dmpanch/rick_tv/rick-tv-pi/provisioning/videolooper/assets/README.md

# Videolooper framebuffer assets

Both `.fb` files are raw 640x480 BGRA framebuffer images for the project display:

- `transition-placeholder.fb` is used while switching channels.
- `interstitial-ad.fb` is used between videos inside the same Rick TV channel.

`interstitial-ad.fb` is derived from a cropped, text-free visible region of the public-domain cover of *Amazing Stories*, April 1942:

https://commons.wikimedia.org/wiki/File:Amazing_stories_194204.jpg

The crop is composed to keep the robot and alien attack scene fullscreen while excluding the original magazine masthead and story text.
