dmpanch/rick_tv/hardware/assets/dpdt-switch.jpg

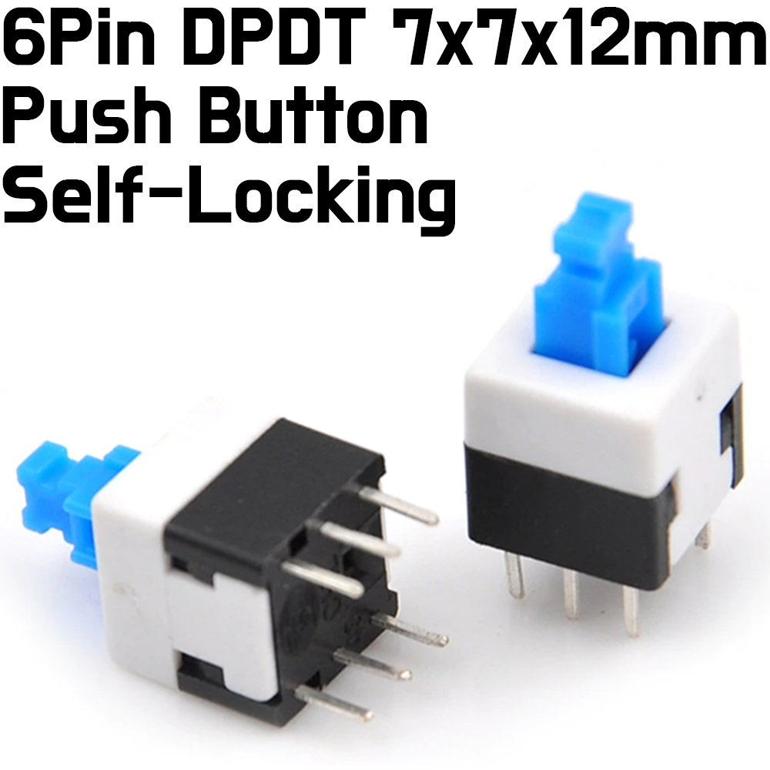
hardware/assets/dpdt-switch.jpg
