dmpanch/rick_tv/hardware/assets/pi-zero-w-back.jpg

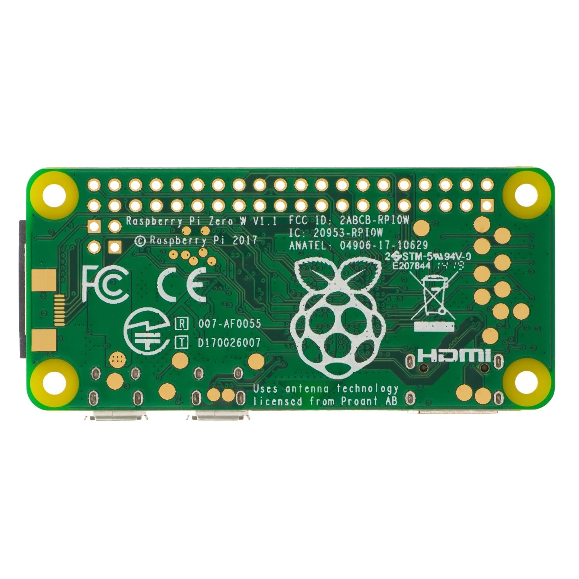
hardware/assets/pi-zero-w-back.jpg
