dmpanch/rick_tv/rick-tv-pi/provisioning/videolooper/overrides/video_looper.py

# Copyright 2015 Adafruit Industries.
# Author: Tony DiCola
# License: GNU GPLv2, see LICENSE.txt

import configparser
import importlib
import os
import re
import subprocess
import sys
import signal
import time
import urllib.parse
import select
import pygame
import json
import threading
from datetime import datetime
import RPi.GPIO as GPIO

from .alsa_config import parse_hw_device
from .model import Playlist, Movie

# Basic video looper architecure:
#
# - VideoLooper class contains all the main logic for running the looper program.
#
# - Almost all state is configured in a .ini config file which is required for
#   loading and using the VideoLooper class.
#
# - VideoLooper has loose coupling with file reader and video player classes that
#   are used to find movie files and play videos respectively.  The configuration
#   defines which file reader and video player module will be loaded.
#
# - A file reader module needs to define at top level create_file_reader function
#   that takes as a parameter a ConfigParser config object.  The function should
#   return an instance of a file reader class.  See usb_drive.py and directory.py
#   for the two provided file readers and their public interface.
#
# - Similarly a video player modules needs to define a top level create_player
#   function that takes in configuration.  See omxplayer.py and hello_video.py
#   for the two provided video players and their public interface.
#
# - Future file readers and video players can be provided and referenced in the
#   config to extend the video player use to read from different file sources
#   or use different video players.
class VideoLooper:

    def __init__(self, config_path):
        """Create an instance of the main video looper application class. Must
        pass path to a valid video looper ini configuration file.
        """
        # Load the configuration.
        self._config = configparser.ConfigParser(interpolation=None)
        if len(self._config.read(config_path)) == 0:
            raise RuntimeError(f"Failed to find configuration file at {config_path}, is the application properly installed?")
        self._console_output = self._config.getboolean('video_looper', 'console_output')
        # Load other configuration values.
        self._osd = self._config.getboolean('video_looper', 'osd')
        self._is_random_unique = self._config.getboolean('video_looper', 'is_random_unique', fallback=False)
        self._is_random = self._config.getboolean('video_looper', 'is_random', fallback=False) or self._is_random_unique
        self._one_shot_playback = self._config.getboolean('video_looper', 'one_shot_playback', fallback=False)
        self._play_on_startup = self._config.getboolean('video_looper', 'play_on_startup', fallback=True)
        self._resume_playlist = self._config.getboolean('video_looper', 'resume_playlist', fallback=False)
        self._playlist_path = self._config.get('playlist', 'path', fallback='')
        self._keyboard_control = self._config.getboolean('control', 'keyboard_control')
        self._keyboard_control_disabled_while_playback = self._config.getboolean('control', 'keyboard_control_disabled_while_playback')
        self._gpio_control_disabled_while_playback = self._config.getboolean('control', 'gpio_control_disabled_while_playback')
        self._copyloader = self._config.getboolean('copymode', 'copyloader')
        # Get seconds for countdown from config
        self._countdown_time = self._config.getint('video_looper', 'countdown_time')
        # Get seconds for waittime bewteen files from config
        self._wait_time = self._config.getint('video_looper', 'wait_time')
        # Get timedisplay settings
        self._datetime_display = self._config.getboolean('video_looper', 'datetime_display')
        self._top_datetime_display_format = self._config.get('video_looper', 'top_datetime_display_format', raw=True)
        self._bottom_datetime_display_format = self._config.get('video_looper', 'bottom_datetime_display_format', raw=True)
        # Parse string of 3 comma separated values like "255, 255, 255" into
        # list of ints for colors.
        self._bgcolor = list(map(int, self._config.get('video_looper', 'bgcolor')
                                             .translate(str.maketrans('','', ','))
                                             .split()))
        self._fgcolor = list(map(int, self._config.get('video_looper', 'fgcolor')
                                             .translate(str.maketrans('','', ','))
                                             .split()))
        # Initialize pygame display only when videolooper's own OSD is enabled.
        if self._osd:
            pygame.display.init()
            pygame.font.init()
            pygame.mouse.set_visible(False)
            self._screen = pygame.display.set_mode((0,0), pygame.FULLSCREEN | pygame.NOFRAME)
            self._size = (pygame.display.Info().current_w, pygame.display.Info().current_h)
            self._bgimage = self._load_bgimage() #a tupple with pyimage, xpos, ypos
            self._blank_screen()
        else:
            self._screen = None
            self._size = (0, 0)
            self._bgimage = (None, 0, 0)
        # Load configured video player and file reader modules.
        self._player = self._load_player()
        self._reader = self._load_file_reader()
        self._playlist = None
        # Load ALSA hardware configuration.
        self._alsa_hw_device = parse_hw_device(self._config.get('alsa', 'hw_device'))
        self._alsa_hw_vol_control = self._config.get('alsa', 'hw_vol_control')
        self._alsa_hw_vol_file = self._config.get('alsa', 'hw_vol_file')
        self._alsa_hw_vol = self._config.get('alsa', 'hw_vol', fallback=None)
        # Load sound volume file name value
        self._sound_vol_file = self._config.get('omxplayer', 'sound_vol_file')
        # default value to 0 millibels (omxplayer)
        self._sound_vol = 0
        # Set other static internal state.
        self._extensions = '|'.join(self._player.supported_extensions())
        if self._osd:
            self._small_font = pygame.font.Font(None, 50)
            self._medium_font   = pygame.font.Font(None, 96)
            self._big_font   = pygame.font.Font(None, 250)
        else:
            self._small_font = None
            self._medium_font = None
            self._big_font = None
        self._running    = True
        # set the inital playback state according to the startup setting.
        self._rick_tv_fifo_path = self._config.get(
            'rick_tv', 'command_fifo', fallback='/tmp/rick-tv-videolooper.fifo'
        )
        self._rick_tv_fifo = None
        self._rick_tv_open_fifo()
        self._rick_tv_playlist_reload = False
        self._rick_tv_pending_video_steps = []
        self._rick_tv_next_reader_check = 0.0
        self._rick_tv_current_playlist_path = None
        self._rick_tv_current_playlist_mtime = None
        self._rick_tv_transition_frame_path = '/home/pi/rick-tv/system/transition-placeholder.fb'
        self._rick_tv_transition_frame = None
        self._rick_tv_interstitial_frame_path = '/home/pi/rick-tv/system/interstitial-ad.fb'
        self._rick_tv_interstitial_frame = None
        self._rick_tv_skip_next_interstitial = False
        self._rick_tv_disable_framebuffer_placeholders = self._rick_tv_env_truthy('RICK_TV_DISABLE_FRAMEBUFFER_PLACEHOLDERS')
        self._rick_tv_clear_stale_framebuffer()
        self._playbackStopped = not self._play_on_startup
        #used for not waiting the first time
        self._firstStart = True

        # start keyboard handler thread:
        # Event handling for key press, if keyboard control is enabled
        if self._keyboard_control:
            self._keyboard_thread = threading.Thread(target=self._handle_keyboard_shortcuts, daemon=True)
            self._keyboard_thread.start()
        
        pinMapSetting = self._config.get('control', 'gpio_pin_map', raw=True)
        self._gpioPinMode = self._config.getboolean('control', 'gpio_pin_mode')

        if pinMapSetting:
            try:
                self._pinMap = json.loads("{"+pinMapSetting+"}")
                self._gpio_setup()
            except Exception:
                self._pinMap = None
                self._print("gpio_pin_map setting is not valid and/or error with GPIO setup")
        else:
            self._pinMap = None

    def _print(self, message):
        """Print message to standard output if console output is enabled."""
        if self._console_output:
            print(f"[{datetime.now()}] {message}")

    def _load_player(self):
        """Load the configured video player and return an instance of it."""
        module = self._config.get('video_looper', 'video_player')
        return importlib.import_module('.' + module, 'Adafruit_Video_Looper').create_player(self._config, screen=self._screen, bgimage=self._bgimage)

    def _load_file_reader(self):
        """Load the configured file reader and return an instance of it."""
        module = self._config.get('video_looper', 'file_reader')
        return importlib.import_module('.' + module, 'Adafruit_Video_Looper').create_file_reader(self._config, self._screen)

    def _load_bgimage(self):
        """Load the configured background image and return an instance of it."""
        image = None
        image_x = 0
        image_y = 0

        if self._config.has_option('video_looper', 'bgimage'):
            imagepath = self._config.get('video_looper', 'bgimage')
            if imagepath != "" and os.path.isfile(imagepath):
                self._print(f"Using {imagepath} as a background")
                image = pygame.image.load(imagepath)

                screen_w, screen_h = self._size
                image_w, image_h = image.get_size()

                screen_aspect_ratio = screen_w / screen_h
                photo_aspect_ratio = image_w / image_h

                if screen_aspect_ratio < photo_aspect_ratio:  # Width is binding
                    new_image_w = screen_w
                    new_image_h = int(new_image_w / photo_aspect_ratio)
                    image = pygame.transform.scale(image, (new_image_w, new_image_h))
                    image_y = (screen_h - new_image_h) // 2

                elif screen_aspect_ratio > photo_aspect_ratio:  # Height is binding
                    new_image_h = screen_h
                    new_image_w = int(new_image_h * photo_aspect_ratio)
                    image = pygame.transform.scale(image, (new_image_w, new_image_h))
                    image_x = (screen_w - new_image_w) // 2

                else:  # Images have the same aspect ratio
                    image = pygame.transform.scale(image, (screen_w, screen_h))

        return (image, image_x, image_y)

    def _is_number(self, s):
        try:
            float(s) 
            return True
        except ValueError:
            return False

    def _build_playlist(self) -> Playlist:
        """Try to build a playlist (object) from a playlist (file).
        Falls back to an auto-generated playlist with all files.
        """
        if self._playlist_path != "":
            if os.path.isabs(self._playlist_path):
                playlist_path = self._playlist_path
                if not os.path.isfile(self._playlist_path):
                    self._print(f"Playlist path {self._playlist_path} does not exist.")
                    return self._build_playlist_from_all_files()
                    #raise RuntimeError('Playlist path {0} does not exist.'.format(playlist_path))
            else:
                paths = self._reader.search_paths()
                
                if not paths:
                    return Playlist([], self._is_random, self._is_random_unique, self._resume_playlist)
                
                for path in paths:
                    maybe_playlist_path = os.path.join(path, self._playlist_path)
                    if os.path.isfile(maybe_playlist_path):
                        playlist_path = maybe_playlist_path
                        self._print(f"Playlist path resolved to {playlist_path}.")
                        break
                else:
                    self._print(f"Playlist path {self._playlist_path} does not resolve to any file.")
                    return self._build_playlist_from_all_files()
                    #raise RuntimeError('Playlist path {0} does not resolve to any file.'.format(playlist_path))

            basepath, extension = os.path.splitext(playlist_path)
            if extension == '.m3u' or extension == '.m3u8':
                return self._build_playlist_m3u(playlist_path)
            else:
                self._print(f'Unrecognized playlist format {extension}.')
                return self._build_playlist_from_all_files()
                #raise RuntimeError('Unrecognized playlist format {0}.'.format(extension))
        else:
            return self._build_playlist_from_all_files()
    
    def _build_playlist_m3u(self, playlist_path: str) -> Playlist:
        """
        Build a playlist from an M3U or M3U8 file.

        :param self: The instance of the video looper.
        :param playlist_path: The path to the M3U or M3U8 playlist file.
        :type playlist_path: str
        :return: A Playlist object containing the movies from the playlist file.
        :rtype: Playlist
        """
        playlist_dirname = os.path.dirname(playlist_path)
        movies = []

        title = None

        with open(playlist_path) as f:
            for line in f:
                if line.startswith('#'):
                    if line.startswith('#EXTINF'):
                        matches = re.match(r'^#\w+:\d+(?:\s*\w+\=\".*\")*,(.*)$', line)
                        if matches:
                            title = matches[1]
                else:
                    path = urllib.parse.unquote(line.rstrip())
                    if not os.path.isabs(path):
                        path = os.path.join(playlist_dirname, path)
                    movies.append(Movie(path, title))
                    title = None

        return Playlist(movies, self._is_random, self._is_random_unique, self._resume_playlist)

    def _build_playlist_from_all_files(self) -> Playlist:
        """Search all the file reader paths for movie files with the provided
        extensions.
        """
        # Get list of paths to search from the file reader.
        paths = self._reader.search_paths()
        # Enumerate all movie files inside those paths.
        movies = []
        for path in paths:
            # Skip paths that don't exist or are files.
            if not os.path.exists(path) or not os.path.isdir(path):
                continue

            for x in os.listdir(path):
                # Ignore hidden files (useful when file loaded on usb key from an OSX computer
                if x[0] != '.' and re.search(r'\.({0})$'.format(self._extensions), x, flags=re.IGNORECASE):
                    moviename = None
                    repeatsetting = re.search(r'_repeat_(-?)([0-9]*)x', x, flags=re.IGNORECASE)
                    if (repeatsetting is not None and repeatsetting.group(2) != ''):
                        repeat = int(repeatsetting.group(1) + repeatsetting.group(2))
                        moviename = os.path.splitext(re.sub(r'_repeat_(-?)([0-9]*)x', '', x, flags=re.IGNORECASE))[0]
                    else:
                        repeat = 1
                        moviename = os.path.splitext(x)[0]
                    movies.append(Movie(f"{path.rstrip('/')}/{x}", moviename, repeat))

            # Get the ALSA hardware volume from the file in the usb key
            if self._alsa_hw_vol_file:
                alsa_hw_vol_file_path = f"{path.rstrip('/')}/{self._alsa_hw_vol_file}"
                if os.path.exists(alsa_hw_vol_file_path):
                    with open(alsa_hw_vol_file_path, 'r') as alsa_hw_vol_file:
                        alsa_hw_vol_string = alsa_hw_vol_file.readline()
                        self._alsa_hw_vol = alsa_hw_vol_string
                    
            # Get the video volume from the file in the usb key
            if self._sound_vol_file:
                sound_vol_file_path = f"{path.rstrip('/')}/{self._sound_vol_file}"
                if os.path.exists(sound_vol_file_path):
                    with open(sound_vol_file_path, 'r') as sound_file:
                        sound_vol_string = sound_file.readline()
                        if self._is_number(sound_vol_string):
                            self._sound_vol = int(float(sound_vol_string))
        # Create a playlist with the sorted list of movies.
        return Playlist(sorted(movies), self._is_random, self._is_random_unique, self._resume_playlist)

    def _blank_screen(self):
        """Render a blank screen filled with the background color and optional the background image."""
        if not self._osd:
            return
        self._screen.fill(self._bgcolor)
        if self._bgimage[0] is not None:
            self._screen.blit(self._bgimage[0], (self._bgimage[1], self._bgimage[2]))
        pygame.display.flip()

    def _render_text(self, message, font=None):
        """Draw the provided message and return as pygame surface of it rendered
        with the configured foreground and background color.
        """
        # Default to small font if not provided.
        if font is None:
            font = self._small_font
        return font.render(message, True, self._fgcolor, self._bgcolor)

    def _animate_countdown(self, playlist):
        """Print text with the number of loaded movies and a quick countdown
        message if the on screen display is enabled.
        """
        # Print message to console with number of media files in playlist.
        message = f"Found {playlist.length()} media file{'s' if playlist.length() >= 2 else ''}."
        self._print(message)
        # Do nothing else if the OSD is turned off.
        if not self._osd:
            return
        # Draw message with number of movies loaded and animate countdown.
        # First render text that doesn't change and get static dimensions.
        label1 = self._render_text(message + " Starting playback in:")
        l1w, l1h = label1.get_size()
        sw, sh = self._screen.get_size()
        for i in range(self._countdown_time, 0, -1):
            # Each iteration of the countdown rendering changing text.
            label2 = self._render_text(str(i), self._big_font)
            l2w, l2h = label2.get_size()
            # Clear screen and draw text with line1 above line2 and all
            # centered horizontally and vertically.
            self._screen.fill(self._bgcolor)
            self._screen.blit(label1, (round(sw/2-l1w/2), round(sh/2-l2h/2-l1h)))
            self._screen.blit(label2, (round(sw/2-l2w/2), round(sh/2-l2h/2)))
            pygame.display.update()
            # Pause for a second between each frame.
            time.sleep(1)

    def _display_datetime(self):
        # returns suffix based on the day
        def get_day_suffix(day):
            if day in [1, 21, 31]:
                suffix = "st"
            elif day in [2, 22]:
                suffix = "nd"
            elif day in [3, 23]:
                suffix = "rd"
            else:
                suffix = "th"
            return suffix

        sw, sh = self._screen.get_size()

        for i in range(self._wait_time):
            if self._running:
                now = datetime.now()

                # Get the day suffix
                suffix = get_day_suffix(int(now.strftime('%d')))

                # Format the time and date strings
                top_format = self._top_datetime_display_format.replace('%d{SUFFIX}', f'%d{suffix}')
                bottom_format = self._bottom_datetime_display_format.replace('%d{SUFFIX}', f'%d{suffix}')

                top_str = now.strftime(top_format)
                bottom_str = now.strftime(bottom_format)

                # Render the time and date labels
                top_label = self._render_text(top_str, self._big_font)
                bottom_label = self._render_text(bottom_str, self._medium_font)

                # Calculate the label positions
                l1w, l1h = top_label.get_size()
                l2w, l2h = bottom_label.get_size()

                top_x = sw // 2 - l1w // 2
                top_y = sh // 2 - (l1h + l2h) // 2
                bottom_x = sw // 2 - l2w // 2
                bottom_y = top_y + l1h + 50

                # Draw the labels to the screen

                self._screen.fill(self._bgcolor)
                self._screen.blit(top_label, (top_x, top_y))
                self._screen.blit(bottom_label, (bottom_x, bottom_y))
                pygame.display.update()

                time.sleep(1)

    def _idle_message(self):
        """Print idle message from file reader."""
        # Print message to console.
        message = self._reader.idle_message()
        self._print(message)
        # Do nothing else if the OSD is turned off.
        if not self._osd:
            return
        # Display idle message in center of screen.
        label = self._render_text(message)
        lw, lh = label.get_size()
        sw, sh = self._screen.get_size()
        self._screen.fill(self._bgcolor)
        self._screen.blit(label, (sw/2-lw/2, sh/2-lh/2))
        # If keyboard control is enabled, display message about it
        if self._keyboard_control:
            label2 = self._render_text('press ESC to quit')
            l2w, l2h = label2.get_size()
            self._screen.blit(label2, (sw/2-l2w/2, sh/2-l2h/2+lh))
        pygame.display.update()

    def display_message(self,message):
        self._print(message)
        # Do nothing else if the OSD is turned off.
        if not self._osd:
            return
        # Display idle message in center of screen.
        label = self._render_text(message)
        lw, lh = label.get_size()
        sw, sh = self._screen.get_size()
        self._screen.fill(self._bgcolor)
        self._screen.blit(label, (sw/2-lw/2, sh/2-lh/2))
        pygame.display.update()

    def _prepare_to_run_playlist(self, playlist):
        """Display messages when a new playlist is loaded."""
        # If there are movies to play show a countdown first (if OSD enabled),
        # or if no movies are available show the idle message.
        self._blank_screen()
        self._firstStart = True
        self._print(f"Playlist:\n{playlist}")
        if playlist.length() > 0:
            self._animate_countdown(playlist)
            self._blank_screen()
        else:
            self._idle_message()

    def _set_hardware_volume(self):
        if self._alsa_hw_vol is not None:
            self._print(f"setting hardware volume (device: {self._alsa_hw_device}, control: {self._alsa_hw_vol_control}, value: {self._alsa_hw_vol})")
            cmd = ['amixer', '-M']
            if self._alsa_hw_device is not None:
                cmd.extend(('-c', str(self._alsa_hw_device[0])))
            cmd.extend(('set', self._alsa_hw_vol_control, '--', self._alsa_hw_vol))
            subprocess.check_call(cmd)
            
    def _rick_tv_open_fifo(self):
        if not self._rick_tv_fifo_path:
            return
        try:
            if not os.path.exists(self._rick_tv_fifo_path):
                os.mkfifo(self._rick_tv_fifo_path)
            os.chmod(self._rick_tv_fifo_path, 0o666)
            self._rick_tv_fifo = os.open(self._rick_tv_fifo_path, os.O_RDONLY | os.O_NONBLOCK)
            self._print(f"Rick TV command FIFO ready: {self._rick_tv_fifo_path}")
        except OSError as exc:
            self._rick_tv_fifo = None
            self._print(f"Rick TV command FIFO unavailable: {exc}")
    def _rick_tv_handle_fifo_commands(self):
        if self._rick_tv_fifo is None:
            return
        readable, _, _ = select.select([self._rick_tv_fifo], [], [], 0)
        if not readable:
            return
        try:
            payload = os.read(self._rick_tv_fifo, 4096).decode('utf-8')
        except OSError as exc:
            self._print(f"Rick TV command FIFO read failed: {exc}")
            return
        if payload == '':
            os.close(self._rick_tv_fifo)
            self._rick_tv_fifo = None
            self._rick_tv_open_fifo()
            return
        for command in payload.splitlines():
            command = command.strip()
            if not command:
                continue
            self._print(f"Rick TV FIFO command received: {command}")
            if command in ('next_video', 'previous_video'):
                self._rick_tv_pending_video_steps.append(1 if command == 'next_video' else -1)
                continue
            if '.m3u' in command:
                playlist_mtime = self._rick_tv_playlist_mtime(command)
                same_playlist = command == self._rick_tv_current_playlist_path
                self._print(
                    "Rick TV FIFO playlist command details: "
                    f"same_playlist={same_playlist}, "
                    f"playlist_mtime={playlist_mtime}, "
                    f"current_playlist={self._rick_tv_current_playlist_path}, "
                    f"current_mtime={self._rick_tv_current_playlist_mtime}"
                )
                if (
                    same_playlist
                    and playlist_mtime == self._rick_tv_current_playlist_mtime
                ):
                    self._print(f"Rick TV playlist command unchanged; ignoring: {command}")
                    continue
                if same_playlist:
                    self._print(
                        "Rick TV same-channel playlist refresh; transition placeholder suppressed: "
                        f"{command}"
                    )
                else:
                    self._print(f"Rick TV loading playlist: {command}")
                self._playlist_path = command
                self._print(f"Rick TV stopping player for playlist command: {command}")
                self._player.stop(0)
                if not same_playlist:
                    self._rick_tv_show_transition_placeholder()
                    self._print("Rick TV suppressing next interstitial after channel switch")
                    self._rick_tv_skip_next_interstitial = True
                self._playbackStopped = False
                self._rick_tv_pending_video_steps = []
                self._playlist = None
                self._rick_tv_playlist_reload = True
                self._rick_tv_current_playlist_path = command
                self._rick_tv_current_playlist_mtime = playlist_mtime

    def _rick_tv_apply_video_commands(self, movie):
        steps = self._rick_tv_pending_video_steps
        self._rick_tv_pending_video_steps = []
        if not steps or self._playlist is None or self._playlist.length() == 0:
            return movie
        for step in steps:
            self._playlist.seek(step)
            movie = self._playlist.get_next()
            movie.clear_playcount()
        self._player.stop(0)
        self._playbackStopped = False
        self._rick_tv_skip_next_interstitial = True
        self._print(f"Rick TV manual video selection: {movie}")
        return movie

    def _rick_tv_playlist_mtime(self, playlist_path):
        try:
            return os.path.getmtime(playlist_path)
        except OSError:
            return None

    def _rick_tv_reader_changed(self):
        now = time.monotonic()
        if now < self._rick_tv_next_reader_check:
            return False
        self._rick_tv_next_reader_check = now + 1.0
        return self._reader.is_changed()

    def _rick_tv_framebuffer_bytes(self):
        try:
            width, height = self._rick_tv_framebuffer_size()
            stride = self._rick_tv_read_int('/sys/class/graphics/fb0/stride')
        except OSError as exc:
            self._print(f"Rick TV transition placeholder framebuffer size unavailable: {exc}")
            return None
        return stride * height

    def _rick_tv_frame_for_display(self, frame_path):
        expected_bytes = self._rick_tv_framebuffer_bytes()
        if expected_bytes is None:
            return None

        try:
            fd = os.open(frame_path, os.O_RDONLY)
            try:
                frame = os.read(fd, 8 * 1024 * 1024)
            finally:
                os.close(fd)
        except OSError as exc:
            self._print(f"Rick TV transition/interstitial frame unavailable: {exc}")
            return None

        if len(frame) == expected_bytes:
            return frame
        if len(frame) > expected_bytes:
            self._print(
                f"Rick TV frame too large: got {len(frame)} bytes, expected {expected_bytes} bytes. Truncating."
            )
            return frame[:expected_bytes]
        self._print(
            f"Rick TV frame too small: got {len(frame)} bytes, expected {expected_bytes} bytes. Zero-padding."
        )
        return frame + b"\0" * (expected_bytes - len(frame))

    def _rick_tv_show_transition_placeholder(self):
        if not self._rick_tv_framebuffer_placeholders_enabled():
            self._print(
                "Rick TV transition placeholder disabled by RICK_TV_DISABLE_FRAMEBUFFER_PLACEHOLDERS"
            )
            return
        frame = self._rick_tv_transition_frame
        expected_bytes = self._rick_tv_framebuffer_bytes()
        if expected_bytes is None:
            return
        if frame is None:
            frame = self._rick_tv_frame_for_display(self._rick_tv_transition_frame_path)
            if frame is None:
                return
            if len(frame) != expected_bytes:
                return
            self._rick_tv_transition_frame = frame
        elif len(frame) != expected_bytes:
            frame = self._rick_tv_frame_for_display(self._rick_tv_transition_frame_path)
            if frame is None or len(frame) != expected_bytes:
                return
            self._rick_tv_transition_frame = frame
        if not frame:
            return
        self._rick_tv_prepare_framebuffer_console()
        try:
            fd = os.open('/dev/fb0', os.O_WRONLY)
            try:
                self._print("Rick TV showing transition placeholder")
                os.write(fd, frame)
            finally:
                os.close(fd)
        except OSError as exc:
            self._print(f"Rick TV transition placeholder unavailable: {exc}")

    def _rick_tv_show_interstitial_ad(self):
        if not self._rick_tv_framebuffer_placeholders_enabled():
            self._print(
                "Rick TV interstitial ad disabled by RICK_TV_DISABLE_FRAMEBUFFER_PLACEHOLDERS"
            )
            return
        frame = self._rick_tv_interstitial_frame
        expected_bytes = self._rick_tv_framebuffer_bytes()
        if expected_bytes is None:
            return
        if frame is None:
            frame = self._rick_tv_frame_for_display(self._rick_tv_interstitial_frame_path)
            if frame is None:
                return
            if len(frame) != expected_bytes:
                return
            self._rick_tv_interstitial_frame = frame
        elif len(frame) != expected_bytes:
            frame = self._rick_tv_frame_for_display(self._rick_tv_interstitial_frame_path)
            if frame is None or len(frame) != expected_bytes:
                return
            self._rick_tv_interstitial_frame = frame
        if not frame:
            return
        self._rick_tv_prepare_framebuffer_console()
        try:
            fd = os.open('/dev/fb0', os.O_WRONLY)
            try:
                self._print("Rick TV showing interstitial ad")
                os.write(fd, frame)
            finally:
                os.close(fd)
        except OSError as exc:
            self._print(f"Rick TV interstitial ad unavailable: {exc}")

    def _rick_tv_framebuffer_placeholders_enabled(self):
        return not self._rick_tv_disable_framebuffer_placeholders

    def _rick_tv_clear_stale_framebuffer(self):
        if not self._rick_tv_disable_framebuffer_placeholders:
            return
        expected_bytes = self._rick_tv_framebuffer_bytes()
        if expected_bytes is None:
            return
        try:
            fd = os.open('/dev/fb0', os.O_WRONLY)
            try:
                chunk = b'\0' * 65536
                remaining = expected_bytes
                while remaining > 0:
                    written = os.write(fd, chunk[:min(len(chunk), remaining)])
                    if written <= 0:
                        break
                    remaining -= written
                self._print(
                    "Rick TV cleared stale framebuffer because RICK_TV_DISABLE_FRAMEBUFFER_PLACEHOLDERS is enabled"
                )
            finally:
                os.close(fd)
        except OSError as exc:
            self._print(f"Rick TV stale framebuffer clear failed: {exc}")

    def _rick_tv_env_truthy(self, name):
        return self._rick_tv_env_value(name).strip().lower() in ('1', 'true', 'yes', 'on')

    def _rick_tv_env_value(self, name):
        value = os.environ.get(name)
        if value is not None:
            return value
        try:
            fd = os.open('/etc/rick-tv-pi.env', os.O_RDONLY)
            try:
                content = os.read(fd, 65536).decode('utf-8')
            finally:
                os.close(fd)
        except OSError:
            return ''

        for line in content.splitlines():
            line = line.strip()
            if not line or line.startswith('#') or '=' not in line:
                continue
            key, file_value = line.split('=', 1)
            if key.strip() != name:
                continue
            file_value = file_value.strip()
            if (
                len(file_value) >= 2
                and file_value[0] == file_value[-1]
                and file_value[0] in ('"', "'")
            ):
                file_value = file_value[1:-1]
            return file_value
        return ''

    def _rick_tv_prepare_framebuffer_console(self):
        try:
            fd = os.open('/sys/class/graphics/fbcon/cursor_blink', os.O_WRONLY)
            try:
                os.write(fd, b'0')
            finally:
                os.close(fd)
        except OSError:
            pass
        try:
            fd = os.open('/dev/tty1', os.O_WRONLY | os.O_NONBLOCK)
            try:
                os.write(fd, b'\033[?25l\033[2J\033[H')
            finally:
                os.close(fd)
        except OSError:
            pass

    def _rick_tv_build_transition_frame(self):
        try:
            width, height = self._rick_tv_framebuffer_size()
            bpp = self._rick_tv_read_int('/sys/class/graphics/fb0/bits_per_pixel')
            stride = self._rick_tv_read_int('/sys/class/graphics/fb0/stride')
        except OSError as exc:
            self._print(f"Rick TV transition placeholder init failed: {exc}")
            return None
        if bpp != 32:
            self._print(f"Rick TV transition placeholder unsupported bpp: {bpp}")
            return None

        frame = bytearray(stride * height)
        colors = (
            (190, 190, 190),
            (190, 190, 0),
            (0, 190, 190),
            (0, 190, 0),
            (190, 0, 190),
            (190, 0, 0),
            (0, 0, 190),
        )
        bar_width = max(1, width // len(colors))
        for y in range(height):
            for x in range(width):
                self._rick_tv_set_pixel(frame, stride, x, y, colors[min(x // bar_width, len(colors) - 1)])

        for i in range((width * height) // 24):
            x = (i * 1103515245 + 12345) % width
            y = (i * 214013 + 2531011) % height
            shade = (i * 37) % 256
            self._rick_tv_set_pixel(frame, stride, x, y, (shade, shade, shade))

        band_h = max(120, height // 5)
        band_y = height - band_h
        self._rick_tv_rect(frame, stride, 0, band_y, width, band_h, (0, 0, 0))
        self._rick_tv_rect_outline(frame, stride, width // 12, band_y + 24, width * 5 // 6, band_h - 48)
        self._rick_tv_draw_text(frame, stride, width // 2 - 110, band_y + 48, 'RICK TV', 7)
        self._rick_tv_draw_text(frame, stride, width // 2 - 144, band_y + 112, 'CHANNEL SYNC', 4)
        return bytes(frame)

    def _rick_tv_framebuffer_size(self):
        raw = self._rick_tv_read_text('/sys/class/graphics/fb0/virtual_size')
        width, height = raw.split(',', 1)
        return int(width), int(height)

    def _rick_tv_read_int(self, path):
        return int(self._rick_tv_read_text(path))

    def _rick_tv_read_text(self, path):
        fd = os.open(path, os.O_RDONLY)
        try:
            return os.read(fd, 128).decode('ascii').strip()
        finally:
            os.close(fd)

    def _rick_tv_set_pixel(self, frame, stride, x, y, rgb):
        r, g, b = rgb
        offset = y * stride + x * 4
        frame[offset:offset + 4] = bytes((b, g, r, 0))

    def _rick_tv_rect(self, frame, stride, x, y, w, h, rgb):
        for yy in range(max(0, y), max(0, y) + max(0, h)):
            for xx in range(max(0, x), max(0, x) + max(0, w)):
                self._rick_tv_set_pixel(frame, stride, xx, yy, rgb)

    def _rick_tv_rect_outline(self, frame, stride, x, y, w, h):
        for i in range(4):
            self._rick_tv_rect(frame, stride, x + i, y + i, w - i * 2, 1, (255, 255, 255))
            self._rick_tv_rect(frame, stride, x + i, y + h - i - 1, w - i * 2, 1, (255, 255, 255))
            self._rick_tv_rect(frame, stride, x + i, y + i, 1, h - i * 2, (255, 255, 255))
            self._rick_tv_rect(frame, stride, x + w - i - 1, y + i, 1, h - i * 2, (255, 255, 255))

    def _rick_tv_draw_text(self, frame, stride, x, y, text, scale):
        font = {
            'A': ('01110', '10001', '10001', '11111', '10001', '10001', '10001'),
            'C': ('01111', '10000', '10000', '10000', '10000', '10000', '01111'),
            'E': ('11111', '10000', '10000', '11110', '10000', '10000', '11111'),
            'H': ('10001', '10001', '10001', '11111', '10001', '10001', '10001'),
            'I': ('11111', '00100', '00100', '00100', '00100', '00100', '11111'),
            'K': ('10001', '10010', '10100', '11000', '10100', '10010', '10001'),
            'L': ('10000', '10000', '10000', '10000', '10000', '10000', '11111'),
            'N': ('10001', '11001', '10101', '10011', '10001', '10001', '10001'),
            'R': ('11110', '10001', '10001', '11110', '10100', '10010', '10001'),
            'S': ('01111', '10000', '10000', '01110', '00001', '00001', '11110'),
            'T': ('11111', '00100', '00100', '00100', '00100', '00100', '00100'),
            'V': ('10001', '10001', '10001', '10001', '10001', '01010', '00100'),
            'Y': ('10001', '10001', '01010', '00100', '00100', '00100', '00100'),
            ' ': ('00000', '00000', '00000', '00000', '00000', '00000', '00000'),
        }
        cursor = x
        for char in text:
            glyph = font.get(char.upper(), font[' '])
            for row, bits in enumerate(glyph):
                for col, bit in enumerate(bits):
                    if bit == '1':
                        self._rick_tv_rect(frame, stride, cursor + col * scale, y + row * scale, scale, scale, (255, 255, 255))
            cursor += 6 * scale

    def _handle_keyboard_shortcuts(self):
        self._print("keyboard control thread started")
        while self._running:
            event = pygame.event.wait()

            if self._keyboard_control_disabled_while_playback and self._player.is_playing():
                self._print("keyboard control disabled while playback is running")
                continue
            
            if event.type == pygame.KEYDOWN:
                # If pressed key is ESC quit program
                if event.key == pygame.K_ESCAPE:
                    self._print("ESC was pressed. quitting...")
                    self.quit()
                if event.key == pygame.K_k:
                    self._print("k was pressed. skipping...")
                    self._playlist.seek(1) # type: ignore
                    self._player.stop(0)
                    self._playbackStopped = False
                if event.key == pygame.K_s:
                    if self._playbackStopped:
                        self._print("s was pressed. starting...")
                        self._playbackStopped = False
                    else:
                        self._print("s was pressed. stopping...")
                        self._playbackStopped = True
                        self._player.stop(0)
                # space is pause/resume the playing video
                if event.key == pygame.K_SPACE:
                    self._print("Pause/Resume pressed")
                    self._player.pause()
                if event.key == pygame.K_p:
                    self._print("p was pressed. shutting down...")
                    self.quit(True)
                if event.key == pygame.K_b:
                    self._print("b was pressed. jumping back...")
                    self._playlist.seek(-1) # type: ignore
                    self._player.stop(0)
                    self._playbackStopped = False
                if event.key == pygame.K_o:
                    self._print("o was pressed. next chapter...")
                    self._player.sendKey("o")
                if event.key == pygame.K_i:
                    self._print("i was pressed. previous chapter...")
                    self._player.sendKey("i")
    
    def _handle_gpio_control(self, pin):
        if self._pinMap is None:
            return
        
        if self._gpio_control_disabled_while_playback and self._player.is_playing():
            self._print("gpio control disabled while playback is running")
            return
        
        action = self._pinMap[str(pin)]

        self._print(f"pin {pin} triggered: {action}")
        
        if action in ['K_ESCAPE', 'K_k', 'K_s', 'K_SPACE', 'K_p', 'K_b', 'K_o', 'K_i']:
            pygame.event.post(pygame.event.Event(pygame.KEYDOWN, key=getattr(pygame, action, None)))
        elif ".m3u" in action:
            self._playlist_path = action
            self._playlist = self._build_playlist()
            self._player.stop(0)
            self._playbackStopped = False
        else:
            self._playlist.set_next(action) # type: ignore
            self._player.stop(0)
            self._playbackStopped = False
    
    def _gpio_setup(self):
        if self._pinMap is None:
            return
        GPIO.setmode(GPIO.BOARD)
        for pin in self._pinMap:
            GPIO.setup(int(pin), GPIO.IN, pull_up_down=GPIO.PUD_UP if self._gpioPinMode else GPIO.PUD_DOWN)
            GPIO.add_event_detect(int(pin), GPIO.FALLING if self._gpioPinMode else GPIO.RISING, callback=self._handle_gpio_control,  bouncetime=200) 
            self._print(f"pin {pin} action set to: {self._pinMap[pin]}")

        
    def run(self):
        """Main program loop.  Will never return!"""
        # Get playlist of movies to play from file reader.
        self._playlist = self._build_playlist()
        self._prepare_to_run_playlist(self._playlist)
        self._set_hardware_volume()
        movie = self._playlist.get_next()
        # Main loop to play videos in the playlist and listen for file changes.
        while self._running:
            self._rick_tv_handle_fifo_commands()
            if self._rick_tv_playlist_reload:
                self._print("Rick TV playlist reload requested; rebuilding playlist")
                self._playlist = self._build_playlist()
                movie = self._playlist.get_next()
                self._rick_tv_playlist_reload = False

            movie = self._rick_tv_apply_video_commands(movie)

            # Load and play a new movie if nothing is playing.
            if not self._player.is_playing() and not self._playbackStopped:
                if movie is None:
                    self._print("Current playlist is empty")
                    self._playlist = self._build_playlist()
                    movie = self._playlist.get_next()
                    if movie is None:
                        self._player.stop(0)
                        time.sleep(0.1)
                        continue

                if movie is not None: #just to avoid errors

                    if movie.playcount >= movie.repeats:
                        if not (self._is_random and self._is_random_unique):
                            movie.clear_playcount()
                        movie = self._playlist.get_next()
                    elif self._player.can_loop_count() and movie.playcount > 0:
                        if not (self._is_random and self._is_random_unique):
                            movie.clear_playcount()
                        movie = self._playlist.get_next()
                        
                    ## check if movie is actually a m3u file
                    if movie is not None and ".m3u" in movie.filename: # type: ignore
                        self._playlist_path = movie.target # type: ignore
                        self._playlist = self._build_playlist()
                        movie = self._playlist.get_next()
                    if movie is None:
                        continue

                    if not self._firstStart:
                        if self._rick_tv_skip_next_interstitial:
                            self._print("Rick TV skipping interstitial after channel switch")
                        else:
                            self._rick_tv_show_interstitial_ad()
                    self._rick_tv_skip_next_interstitial = False
                    movie.was_played() # type: ignore

                    if self._wait_time > 0 and not self._firstStart:
                        if(self._datetime_display):
                            self._display_datetime()
                        else:
                            self._print(f"Waiting for: {self._wait_time} seconds")
                            time.sleep(self._wait_time)
                    self._firstStart = False

                    #player loop setting:
                    player_loop = -1 if self._playlist.length()==1 or movie.repeats == -1 else None # type: ignore
                    
                    #generating infotext
                    if self._player.can_loop_count():
                        infotext = f"{movie.repeats} time{'s' if movie.repeats>1 else ''} (player counts loops)" # type: ignore
                    else:
                        infotext = f"{movie.playcount}/{movie.repeats}" # type: ignore
                    if player_loop==-1:
                        infotext = '(endless loop)'

                    #special one-shot playback condition
                    if self._one_shot_playback:
                        self._playbackStopped = True
                        player_loop = None
                                        
                    # Start playing the first available movie.
                    self._print(f"Playing movie: {movie} {infotext}")
                    self._print(f"Rick TV player.play starting: {movie}")
                    # todo: maybe clear screen to black so that background (image/color) is not visible for videos with a resolution that is < screen resolution
                    self._player.play(movie, loop=player_loop, vol = self._sound_vol)

            # Check for changes in the file search path (like USB drives added)
            # and rebuild the playlist.
            if not self._playbackStopped and self._rick_tv_reader_changed():
                self._print("reader changed, stopping player")
                self._player.stop(0)  # Up to 3 second delay waiting for old 
                                      # player to stop.
                self._print("player stopped")
                # Rebuild playlist and show countdown again (if OSD enabled).
                self._playlist = self._build_playlist()
                #refresh background image
                if self._copyloader:
                    self._bgimage = self._load_bgimage()
                self._prepare_to_run_playlist(self._playlist)
                self._set_hardware_volume()
                movie = self._playlist.get_next()

            # Give the CPU some time to do other tasks. low values increase "responsiveness to changes" and reduce the pause between files
            # but increase CPU usage
            # since keyboard commands are handled in a seperate thread this sleeptime mostly influences the pause between files
                        
            time.sleep(0.05)

        self._print("run ended")
        pygame.quit()

    def quit(self, shutdown=False):
        """Shut down the program"""
        self._print("quitting Video Looper")

        if shutdown:
            os.system("sudo shutdown now")

        self._playbackStopped = True
        self._running = False
        if self._osd and pygame.get_init():
            pygame.event.post(pygame.event.Event(pygame.QUIT))

        if self._player is not None:
            self._player.stop()

        if self._pinMap:
            GPIO.cleanup()


    def signal_quit(self, signal, frame):
        """Shut down the program, meant to by called by signal handler."""
        self._print("received signal to quit")
        self.quit()

# Main entry point.
if __name__ == '__main__':
    print('Starting Adafruit Video Looper.')
    # Default config path to /boot.
    config_path = '/boot/video_looper.ini'
    # Override config path if provided as parameter.
    if len(sys.argv) == 2:
        config_path = sys.argv[1]
    # Create video looper.
    videolooper = VideoLooper(config_path)
    # Configure signal handlers to quit on TERM or INT signal.
    signal.signal(signal.SIGTERM, videolooper.signal_quit)
    signal.signal(signal.SIGINT, videolooper.signal_quit)
    # Run the main loop.
    videolooper.run()
