dmpanch/rick_tv/rick-tv-pi/src/rick_tv_pi/videolooper.py

from __future__ import annotations

import errno
import logging
import os
import random
import time
from dataclasses import dataclass
from pathlib import Path
from typing import Callable, Iterable, Optional, Tuple

from rick_tv_pi.channels import Channel

logger = logging.getLogger(__name__)


@dataclass(frozen=True)
class PlayableFile:
    path: Path


class VideolooperController:
    def __init__(
        self,
        playlist_root: Path,
        command_path: Path = Path("/tmp/rick-tv-videolooper.fifo"),
        command_writer: Optional[Callable[[str], None]] = None,
        shuffle_interval_seconds: int = 3600,
        shuffler: Optional[Callable[[list[Path]], list[Path]]] = None,
    ) -> None:
        self.screen_state: str = "empty"
        self.current_file: Optional[PlayableFile] = None
        self._current_channel: Optional[Channel] = None
        self._current_commanded_channel_id: Optional[str] = None
        self._playlist_root = playlist_root
        self._channels_root = playlist_root / "channels"
        self._master_playlist_path = playlist_root / "channels.m3u"
        self._command_path = command_path
        self._command_writer = command_writer or self._write_fifo_command
        self._last_playlist_text_by_channel = {}
        self._last_file_set_by_channel = {}
        self._last_master_playlist_text: Optional[str] = None
        self._next_shuffle_at_by_channel = {}
        self._changed_channel_ids = set()
        self._shuffle_interval_seconds = shuffle_interval_seconds
        self._shuffler = shuffler or _shuffle_files
        self._file_cache = {}

    @property
    def master_playlist_path(self) -> Path:
        return self._master_playlist_path

    def sync_channels(self, channels: Iterable[Channel], now: Optional[float] = None) -> None:
        channels = list(channels)
        current_time = time.monotonic() if now is None else now
        self._playlist_root.mkdir(parents=True, exist_ok=True)
        self._channels_root.mkdir(parents=True, exist_ok=True)
        for channel in channels:
            self._write_channel_playlist_if_due(channel, current_time)

        master_playlist_text = self._build_master_playlist(channels)
        if master_playlist_text == self._last_master_playlist_text:
            return
        self._master_playlist_path.write_text(master_playlist_text)
        self._last_master_playlist_text = master_playlist_text

    def select_channel(self, channel: Channel) -> bool:
        if (
            self._current_channel is not None
            and self._current_channel.id == channel.id
            and self._current_commanded_channel_id == channel.id
        ):
            return True
        self._current_channel = channel
        self._write_channel_playlist_if_due(channel, time.monotonic())
        self._update_state(channel)
        if self.current_file is None:
            self._changed_channel_ids.discard(channel.id)
            return True
        command_sent = self._send_channel_command(channel, force=True)
        self._changed_channel_ids.discard(channel.id)
        return command_sent

    def rescan_current_channel(self, now: Optional[float] = None) -> None:
        if self._current_channel is None:
            self.screen_state = "empty"
            self.current_file = None
            return

        current_time = time.monotonic() if now is None else now
        self._write_channel_playlist_if_due(self._current_channel, current_time)
        self._update_state(self._current_channel)
        if (
            self.current_file is not None
            and self._current_channel.id in self._changed_channel_ids
        ):
            self._send_channel_command(self._current_channel, force=True)
            self._changed_channel_ids.discard(self._current_channel.id)

    def _write_channel_playlist_if_due(self, channel: Channel, now: float) -> bool:
        files = self._channel_files(channel)
        file_set = tuple(files)
        previous_file_set = self._last_file_set_by_channel.get(channel.id)
        next_shuffle_at = self._next_shuffle_at_by_channel.get(channel.id)
        due = (
            previous_file_set != file_set
            or next_shuffle_at is None
            or now >= next_shuffle_at
        )
        if not due:
            return False

        playlist_text, _first_file = self._build_channel_playlist(
            channel,
            files=files,
            shuffle=True,
        )
        last_playlist_text = self._last_playlist_text_by_channel.get(channel.id)
        if playlist_text != last_playlist_text:
            channel_playlist_path = self._channel_playlist_path(channel)
            channel_playlist_path.parent.mkdir(parents=True, exist_ok=True)
            channel_playlist_path.write_text(playlist_text)
            self._last_playlist_text_by_channel[channel.id] = playlist_text
            self._changed_channel_ids.add(channel.id)

        self._last_file_set_by_channel[channel.id] = file_set
        self._next_shuffle_at_by_channel[channel.id] = (
            now + self._shuffle_interval_seconds
        )
        return playlist_text != last_playlist_text

    def _update_state(self, channel: Channel) -> None:
        files = self._channel_files(channel)
        first_file = files[0] if files else None
        self.screen_state = "playing" if first_file is not None else "empty"
        self.current_file = PlayableFile(first_file) if first_file is not None else None

    def _build_master_playlist(self, channels: Iterable[Channel]) -> str:
        lines = ["#EXTM3U"]
        for channel in channels:
            if not self._channel_files(channel):
                continue
            lines.append(f"#EXTINF:0,{_channel_title(channel)}")
            lines.append(str(self._channel_playlist_path(channel)))
        return "\n".join(lines) + "\n"

    def _build_channel_playlist(
        self,
        channel: Channel,
        *,
        files: Optional[list[Path]] = None,
        shuffle: bool,
    ) -> Tuple[str, Optional[Path]]:
        files = self._channel_files(channel) if files is None else list(files)
        if not files:
            return "#EXTM3U\n", None
        if shuffle:
            files = self._shuffler(files)

        title = _channel_title(channel)
        lines = ["#EXTM3U"]
        for path in files:
            lines.append(f"#EXTINF:0,{title}")
            lines.append(str(path))
        return "\n".join(lines) + "\n", files[0]

    def _send_channel_command(self, channel: Channel, *, force: bool = False) -> bool:
        command = str(self._channel_playlist_path(channel))
        if not force and self._current_commanded_channel_id == channel.id:
            return True
        try:
            self._command_writer(command)
        except OSError as exc:
            logger.warning("Videolooper command pipe is unavailable: %s", exc)
            return False
        else:
            self._current_commanded_channel_id = channel.id
            return True

    def next_video(self) -> bool:
        return self._send_video_command("next_video")

    def previous_video(self) -> bool:
        return self._send_video_command("previous_video")

    def _send_video_command(self, command: str) -> bool:
        if self.current_file is None or self._current_channel is None:
            return False
        if not self._send_channel_command(self._current_channel):
            return False
        try:
            self._command_writer(command)
        except OSError as exc:
            logger.warning("Videolooper command pipe is unavailable: %s", exc)
            return False
        return True

    def _write_fifo_command(self, command: str) -> None:
        fd = os.open(str(self._command_path), os.O_WRONLY | os.O_NONBLOCK)
        try:
            os.write(fd, (command + "\n").encode("utf-8"))
        except OSError as exc:
            if exc.errno not in (errno.EPIPE, errno.ENXIO):
                raise
            logger.warning("Videolooper command pipe has no reader: %s", exc)
        finally:
            os.close(fd)

    def _channel_playlist_path(self, channel: Channel) -> Path:
        return self._channels_root / f"{channel.id}.m3u"

    def _channel_files(self, channel: Channel) -> list[Path]:
        try:
            stat = channel.path.stat()
            signature = (stat.st_dev, stat.st_ino, stat.st_mtime_ns, stat.st_ctime_ns)
            cached = self._file_cache.get(channel.path)
            if cached is None or cached[0] != signature:
                cached = (signature, _channel_files(channel))
                self._file_cache[channel.path] = cached
            return list(cached[1])
        except (FileNotFoundError, NotADirectoryError):
            self._file_cache.pop(channel.path, None)
            return []


def _channel_title(channel: Channel) -> str:
    if channel.display_name:
        return f"Channel {channel.number} - {channel.display_name}"
    return f"Channel {channel.number}"


def _channel_files(channel: Channel) -> list[Path]:
    return sorted(
        path
        for path in channel.path.iterdir()
        if path.is_file() and path.suffix.lower() == ".mp4"
    )


def _shuffle_files(files: list[Path]) -> list[Path]:
    files = list(files)
    random.shuffle(files)
    return files
