dmpanch/rick_tv/(commit log)

2026-05-18 feat: wire pi runtime entrypoint
2026-05-19 fix: wire archive delete confirmation
2026-05-19 Reduce touch-to-switch latency path for videolooper
2026-05-19 fix(pi): stabilize videolooper FIFO patching and channel switch path
2026-05-19 Fix videolooper swipe switching stalls on pi
2026-05-19 Reduce videolooper channel switch restarts
2026-05-19 Show framebuffer transition card during channel switches
2026-05-20 Fix videolooper interstitial/transition frame size normalization
2026-05-20 Fix interstitial frame resize when source framebuffer size mismatches
2026-05-20 Revert "Fix interstitial frame resize when source framebuffer size mismatches"
    This reverts commit 3d4362e3c9e2a081470c3721db18850db1a83b4c.
2026-05-20 Fix static framebuffer transition assets
2026-05-20 Prime interstitial framebuffer between videos
2026-05-20 Guard interstitial framebuffer prime after channel switch
2026-05-20 Avoid double interstitial framebuffer flash
2026-06-17 feat: streamline telegram bot channel flow
2026-06-17 chore: remove archive delete flow
2026-06-17 feat: add telegram pi remote channel switching
2026-06-18 feat: add pi firstboot image payload and framebuffer diagnostics
2026-06-18 docs: record pi framebuffer investigation observation
2026-06-18 feat: add pi framebuffer diagnostics collector
2026-06-18 fix: retry telegram remote channel switching
2026-06-18 docs: record framebuffer investigation evidence
2026-06-18 feat: add framebuffer placeholder disable flag
2026-06-18 fix: clear stale framebuffer in placeholder diagnostic mode
2026-06-18 docs: record framebuffer stress findings
2026-06-18 docs: record post-reboot framebuffer soak
2026-06-18 docs: use videolooper.de image for pi setup
2026-06-18 fix: patch videolooper egg inside mounted images
2026-06-18 fix: pin pi image runtime dependencies
2026-06-18 fix: tighten pi env provisioning
2026-07-03 fix pi usb dac audio and channel switch race
2026-09-03 feat: add pi hardware profiles and power button
2026-09-03 fix: toggle dpi backlight from power button
2026-10-19 Update USB Audio DAC model in BOM
    Specify the exact model for the USB Audio DAC as HOCO LS36.
2026-10-19 Update USB Audio Class DAC description in BOM
    Clarified the description of the USB Audio Class DAC.
2026-10-19 Simplify part verification section in BOM.md
    Removed unverified part details and kept references.
2026-10-19 Refine BOM details for power supply and speaker
    Removed redundant phrases and clarified speaker mounting instructions.
2026-10-19 Refine README.md for hardware connections and switches
    Removed redundant information and clarified instructions regarding connections and switch usage.
